rickhc5a/tesis-3dcp-kuka/05_latex/fig/second0.png

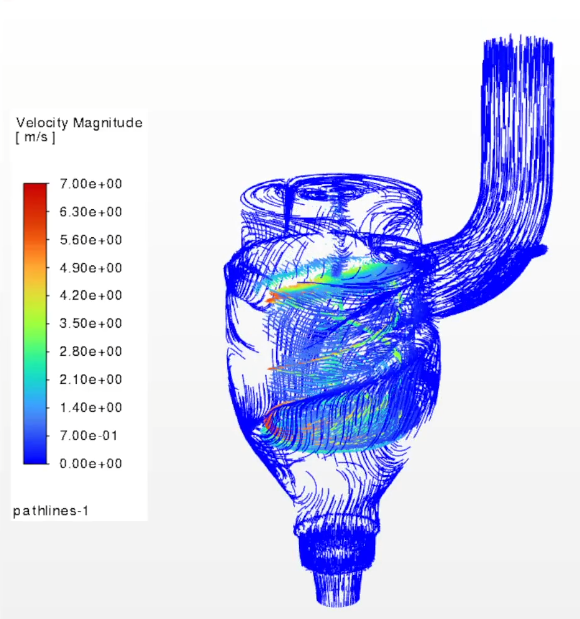
05_latex/fig/second0.png
