rickhc5a/tesis-3dcp-kuka/01_grasshopper/README.md

# 01_grasshopper

Descripción de la carpeta.
