rickhc5a/tesis-3dcp-kuka/05_latex/fig/nozzle_concept.png

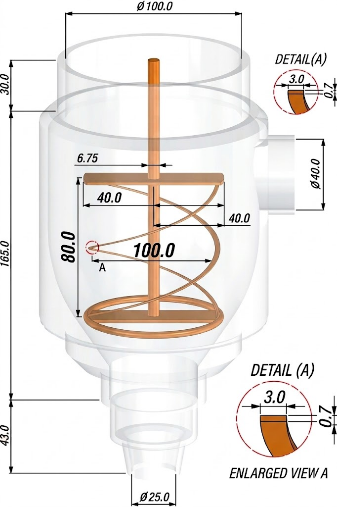
05_latex/fig/nozzle_concept.png
