rickhc5a/tesis-3dcp-kuka/05_latex/fig/pipe_concept.png.png

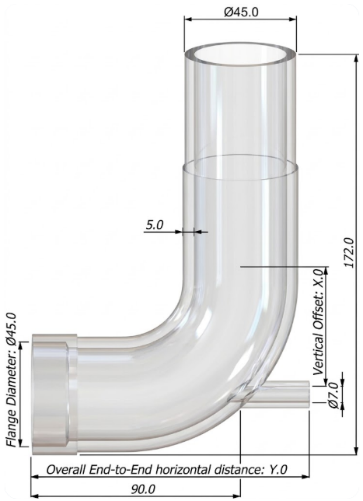
05_latex/fig/pipe_concept.png.png
