rickhc5a/tesis-3dcp-kuka/05_latex/fig/TORQUE.png

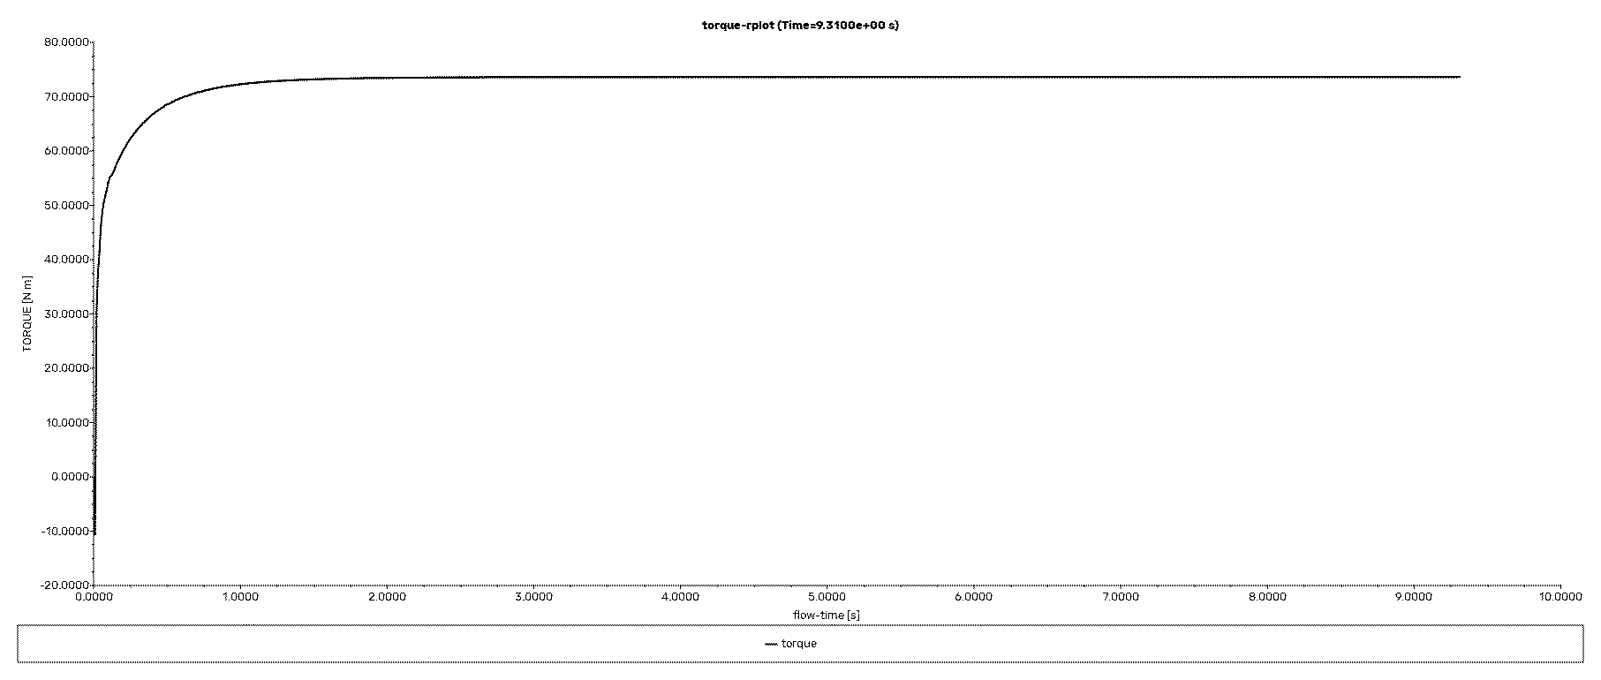
05_latex/fig/TORQUE.png
