rickhc5a/tesis-3dcp-kuka/05_latex/fig/velocity_map.png

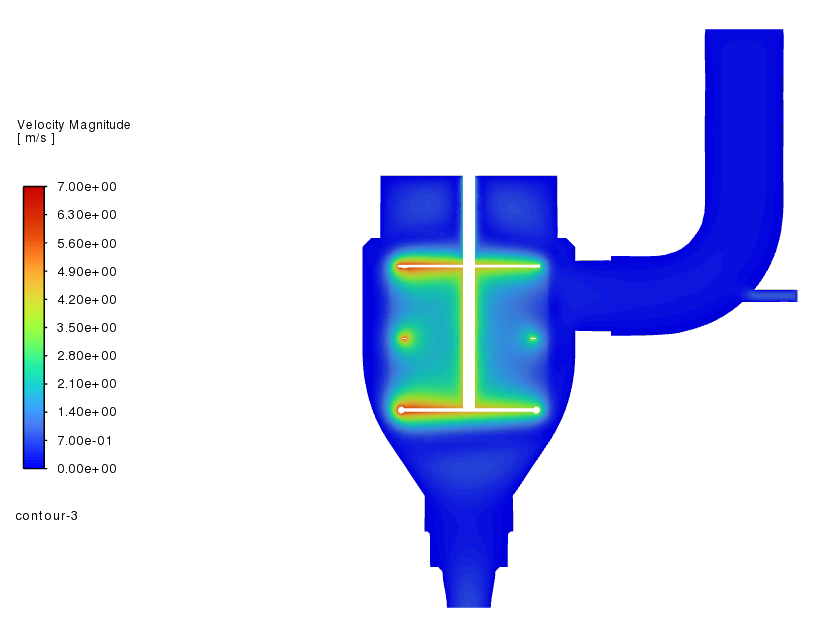
05_latex/fig/velocity_map.png
