rickhc5a/tesis-3dcp-kuka/04_cad/3DCP-NOZZLEv2-abril.stp

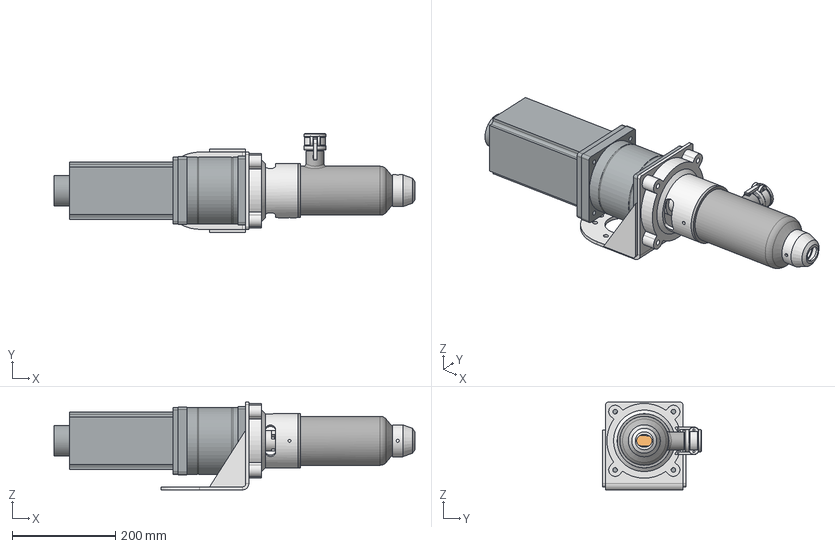
[picture p7: CAD file, 2026-05-12]
04_cad/3DCP-NOZZLEv2-abril.stp
700.5 x 191.9 x 170.2 mm
MEZCLADOR-TRUPPER-80MM
PX130-GEARBOX
SERVOMOTOR-2.3KWv1
AS 1110 - M20 x 80
NYLON-JAW
22MM JAW
22MM JAW_1
NOZZLE-FLANGE
NOZZLE-ELIPTICO
LOWER-NOZZLEv2
UPPER-NOZZLEvF2.0
