rickhc5a/tesis-3dcp-kuka/04_cad/KUKA KR 60-3/KR60-3.stl

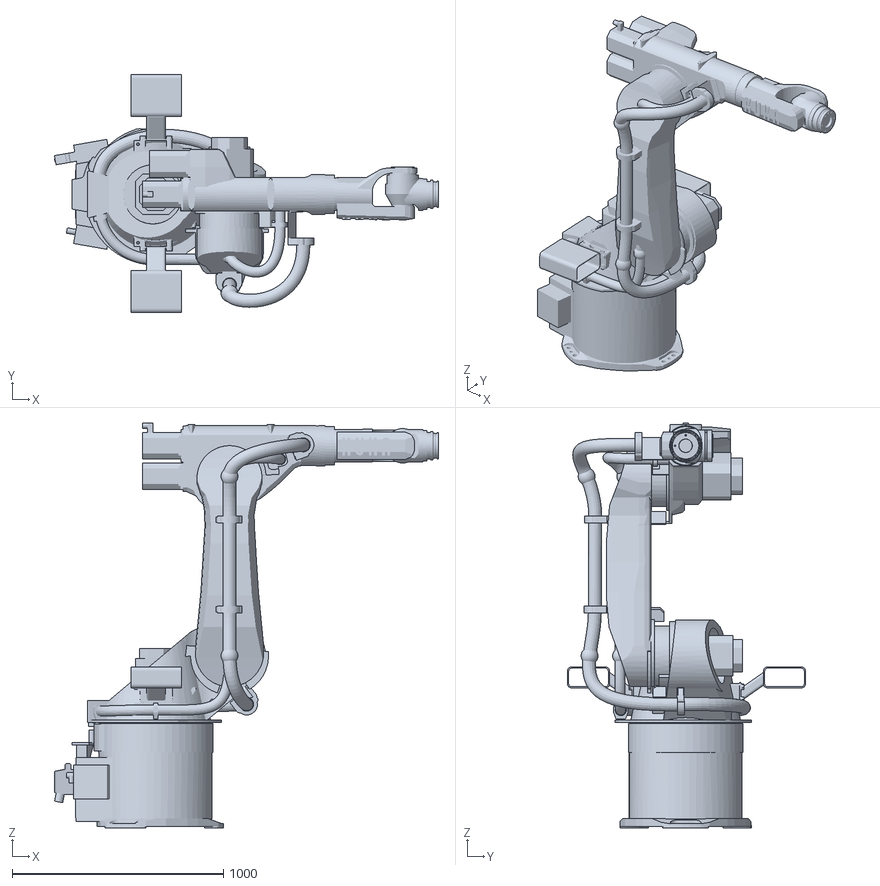
[picture p8: CAD file, 2026-05-12]
04_cad/KUKA KR 60-3/KR60-3.stl
1819.2 x 1128.0 x 1917.8
