rickhc5a/tesis-3dcp-kuka/04_cad/3DCP-NOZZLEv2.stp

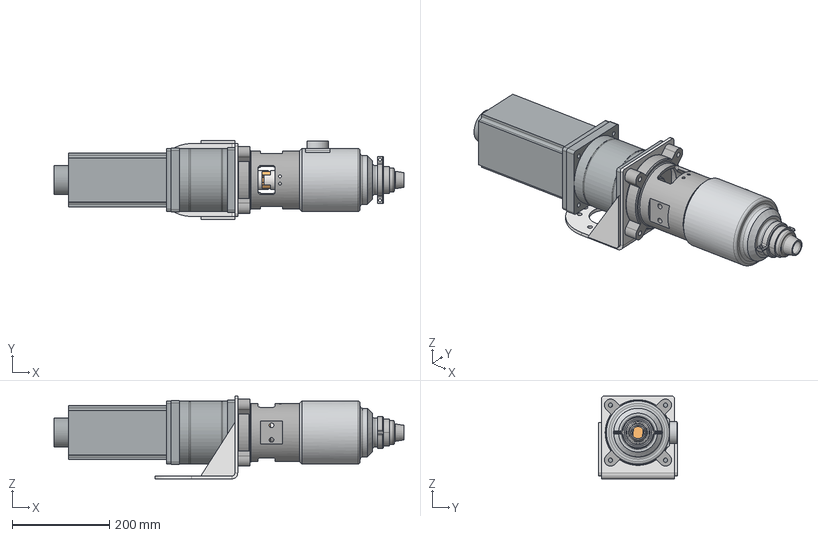
[picture p9: CAD file, 2026-05-12]
04_cad/3DCP-NOZZLEv2.stp
720.0 x 162.0 x 170.2 mm
LOWER-NOZZLEv2
UPPER-NOZZLEv2
EXTRUSSOR-COUPLINGv2 x 2
NOZZLE-EXTRUSOR
MEZCLADOR-TRUPPER-80MM
PX130-GEARBOX
SERVOMOTOR-2.3KWv1
AS 1110 - M20 x 80
NYLON-JAW
22MM JAW
22MM JAW_1
NOZZLE-FLANGE
