rickhc5a/tesis-3dcp-kuka/(list of files, cad)

Other CAD files:
04_cad/220LB LOCK/220LB-ASSY.iam
04_cad/220LB LOCK/220LB-ASSY_MIR.iam
04_cad/220LB LOCK/BODY-220LB.ipt
04_cad/220LB LOCK/BODY-220LB_MIR.ipt
04_cad/220LB LOCK/GRIPPER-220LB.ipt
04_cad/220LB LOCK/GRIPPER-220LB_MIR.ipt
04_cad/220LB LOCK/HEAD-220LB.ipt
04_cad/220LB LOCK/OldVersions/220LB-ASSY.0009.iam
04_cad/220LB LOCK/OldVersions/220LB-ASSY_MIR.0001.iam
04_cad/220LB LOCK/OldVersions/BODY-220LB.0005.ipt
04_cad/220LB LOCK/OldVersions/GRIPPER-220LB.0005.ipt
04_cad/220LB LOCK/OldVersions/PLATE-220.0003.ipt
04_cad/220LB LOCK/PLATE-220.ipt
04_cad/220LB LOCK/PLATE-220_MIR.ipt
04_cad/3DCP-NOZZLE.iam
04_cad/3DCP-NOZZLEv2.iam
04_cad/3DCP-NOZZLEv2.ipn
04_cad/3DCP-SYSTEM.iam
04_cad/ACOPLE CAMLOCK B 3-4in.ipt
04_cad/AUGER-SCREW.ipt
04_cad/COMPONENTS/1-1&2 FEMALE ADAPTER.ipt
04_cad/COMPONENTS/20MM JAW.ipt
04_cad/COMPONENTS/22MM JAW.ipt
04_cad/COMPONENTS/22mm-BEARING.iam
04_cad/COMPONENTS/62_22_01.ipt
04_cad/COMPONENTS/62_22_02.ipt
04_cad/COMPONENTS/62_22_03.ipt
04_cad/COMPONENTS/CAMLOCK TIPO B 3'4IN.ipt
04_cad/COMPONENTS/JAW-COUPLING-ID22MM.iam
04_cad/COMPONENTS/LOWER-JAW.ipt
04_cad/COMPONENTS/M4-HEATINSERT.ipt
04_cad/COMPONENTS/M8-HEATINSERT.ipt
04_cad/COMPONENTS/MEZCLADOR-TRUPPER-80MM.ipt
04_cad/COMPONENTS/MOTOR5HP.ipt
04_cad/COMPONENTS/NYLON-JAW.ipt
04_cad/COMPONENTS/OldVersions/20MM JAW.0001.ipt
04_cad/COMPONENTS/OldVersions/22MM JAW.0002.ipt
04_cad/COMPONENTS/OldVersions/22mm-BEARING.0001.iam
04_cad/COMPONENTS/OldVersions/CAMLOCK TIPO B 3'4IN.0001.ipt
04_cad/COMPONENTS/OldVersions/JAW-COUPLING-ID22MM.0003.iam
04_cad/COMPONENTS/OldVersions/JAW-COUPLING.0001.ipt
04_cad/COMPONENTS/OldVersions/LOWER-JAW.0003.ipt
04_cad/COMPONENTS/OldVersions/M4-HEATINSERT.0002.ipt
04_cad/COMPONENTS/OldVersions/MEZCLADOR-TRUPPER-80MM.0002.ipt
04_cad/COMPONENTS/OldVersions/NYLON-JAW.0002.ipt
04_cad/COMPONENTS/OldVersions/PX130-GEARBOX.0005.ipt
04_cad/COMPONENTS/OldVersions/SERVOMOTOR-1KW.0005.ipt
04_cad/COMPONENTS/OldVersions/SERVOMOTOR-2.3KWv1.0001.ipt
04_cad/COMPONENTS/PX130-GEARBOX.ipt
04_cad/COMPONENTS/SCREW-ROTOR.ipt
04_cad/COMPONENTS/SERVOMOTOR-1KWv1.ipt
04_cad/COMPONENTS/SERVOMOTOR-2.3KWv1.ipt
04_cad/EXTRUSSOR-COUPLING.ipt
04_cad/EXTRUSSOR-COUPLINGv2.ipt
04_cad/FEE-PIPE.ipt
04_cad/GEARBOX-SUPPORT.ipt
04_cad/HOSE-NOZZLE-MOUNTING.ipt
04_cad/KUKA KR 60-3/KR60-3.ipt
04_cad/LOWER-NOZZLE.ipt
04_cad/LOWER-NOZZLEv2.ipt
04_cad/LOWER-NOZZLEv3.ipt
04_cad/M20 x 80.ipt
04_cad/MOTOR-BRACKET.ipt
04_cad/MOUNTING-COUPLE.ipt
04_cad/NOZZLE-EXTRUSOR.ipt
04_cad/NOZZLE-FLANGE.ipt
04_cad/NOZZLES/NOZZLE-ELIPTICO.ipt
04_cad/NOZZLES/OldVersions/NOZZLE-ELIPTICO.0006.ipt
04_cad/OldVersions/3DCP-NOZZLE.0017.iam
04_cad/OldVersions/3DCP-NOZZLEv2.0030.iam
04_cad/OldVersions/ACOPLE CAMLOCK B 3-4in.0003.ipt
04_cad/OldVersions/AUGER-SCREW.0025.ipt
04_cad/OldVersions/EXTRUSSOR-COUPLING.0001.ipt
04_cad/OldVersions/EXTRUSSOR-COUPLINGv2.0001.ipt
04_cad/OldVersions/FEE-PIPE.0011.ipt
04_cad/OldVersions/GEARBOX-SUPPORT.0009.ipt
04_cad/OldVersions/HOSE-NOZZLE-MOUNTING.0009.ipt
04_cad/OldVersions/LOWER-NOZZLE.0002.ipt
04_cad/OldVersions/LOWER-NOZZLEv2 - copia.0017.ipt
04_cad/OldVersions/LOWER-NOZZLEv2.0016.ipt
04_cad/OldVersions/LOWER-NOZZLEv2.0017.ipt
04_cad/OldVersions/LOWER-NOZZLEv3.0017.ipt
04_cad/OldVersions/M20 x 80.0004.ipt
04_cad/OldVersions/MOTOR-BRACKET.0007.ipt
04_cad/OldVersions/MOUNTING-COUPLE.0006.ipt
04_cad/OldVersions/NOZZLE-EXTRUSOR.0003.ipt
04_cad/OldVersions/NOZZLE-FLANGE.0001.ipt
04_cad/OldVersions/PAPER-VIEW.0003.iam
04_cad/OldVersions/SYSTEM-FLANGE-K60.0001.ipt
04_cad/OldVersions/SYSTEM-FLANGE-LOWER.0004.ipt
04_cad/OldVersions/SYSTEM-FLANGE.0006.iam
04_cad/OldVersions/UPPER-NOZZLE.0022.ipt
04_cad/OldVersions/UPPER-NOZZLEv2.0016.ipt
04_cad/OldVersions/UPPER-NOZZLEv3.0014.ipt
04_cad/OldVersions/UPPER-NOZZLEv3.1.0005.ipt
04_cad/OldVersions/UPPER-NOZZLEvF2.0.0005.ipt
04_cad/PAPER-VIEW.iam
04_cad/PLANOS/3DCP-NOZZLE.idw
04_cad/PLANOS/3DCP-NOZZLEv2-ASSY.idw
04_cad/PLANOS/3DCP-NOZZLEv2.idw
04_cad/PLANOS/FLANGE-INFERIOR.idw
04_cad/PLANOS/FLANGE-SUPERIOR.idw
04_cad/PLANOS/LOWER-NOZZLE.idw
04_cad/PLANOS/OldVersions/3DCP-NOZZLE.0002.idw
04_cad/PLANOS/OldVersions/3DCP-NOZZLEv2.0001.idw
04_cad/PLANOS/OldVersions/FLANGE-SUPERIOR.0002.idw
04_cad/PLANOS/PAPER-VIEWS.idw
04_cad/PLANOS/UPPER-NOZZLE.idw
04_cad/SYSTEM-FLANGE-K60.ipt
04_cad/SYSTEM-FLANGE-LOWER.ipt
04_cad/SYSTEM-FLANGE.iam
04_cad/UPPER-NOZZLE.ipt
04_cad/UPPER-NOZZLEv2.ipt
04_cad/UPPER-NOZZLEv3.1.ipt
04_cad/UPPER-NOZZLEv3.ipt
04_cad/UPPER-NOZZLEvF1.0.ipt
04_cad/UPPER-NOZZLEvF2.0.ipt
