rickhc5a/tesis-3dcp-kuka/04_cad/PLANOS/PAPER-VIEW.pdf

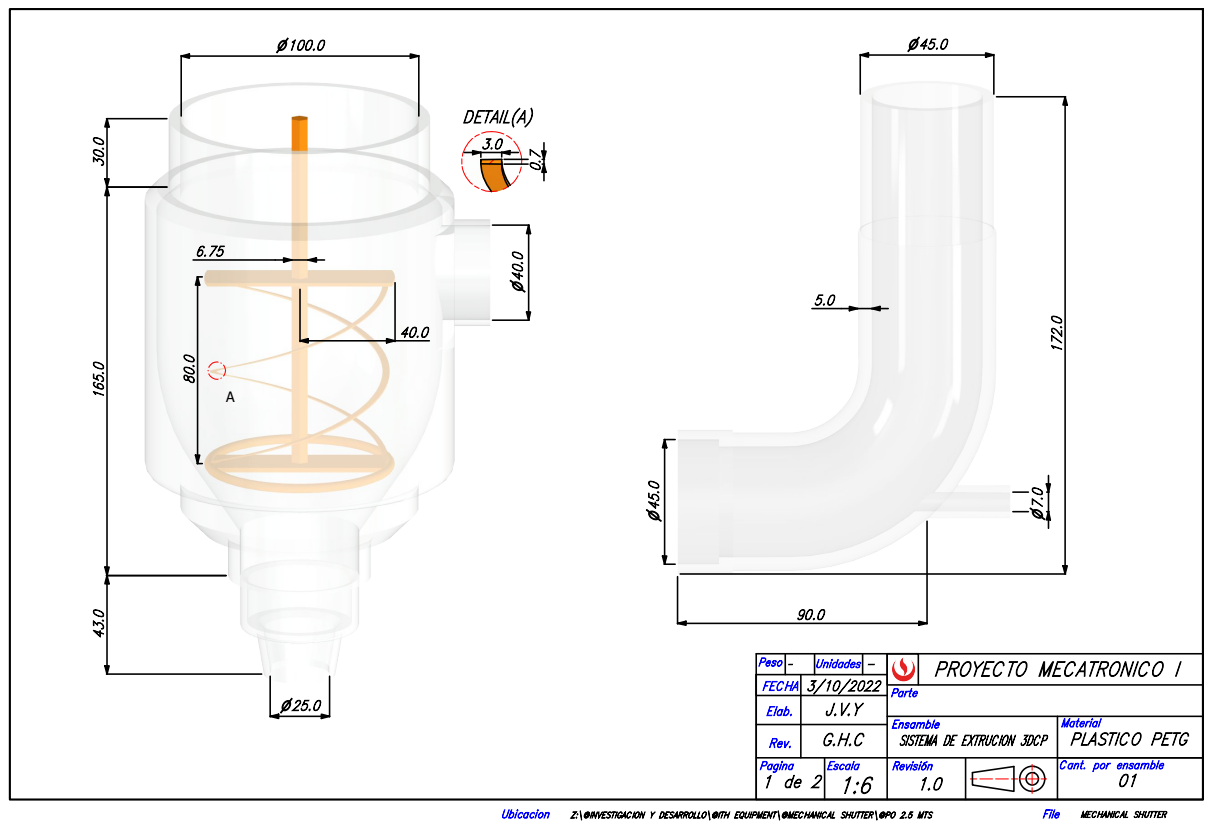
[picture p10: page 1]
Ubicacion; Z:\@INVESTIGACION Y DESARROLLO\@ITH EQUIPMENT\@MECHANICAL SHUTTER\@PO 2.5 MTS; File; MECHANICAL SHUTTER

Peso - | | Unidades - | PROYECTO MECATRONICO I
FECHA | 3/10/2022

Elab. | J.V.Y

Ensamble SISTEMA DE EXTRUCION 3DCP | Material PLASTICO PETG

Rev. | G.H.C
Pagina 1 de 2 | Escala 1:6 | Revisión 1.0 | Cant. por ensamble 01
