rickhc5a/tesis-3dcp-kuka/04_cad/PLANOS/3DCP-NOZZLE.pdf

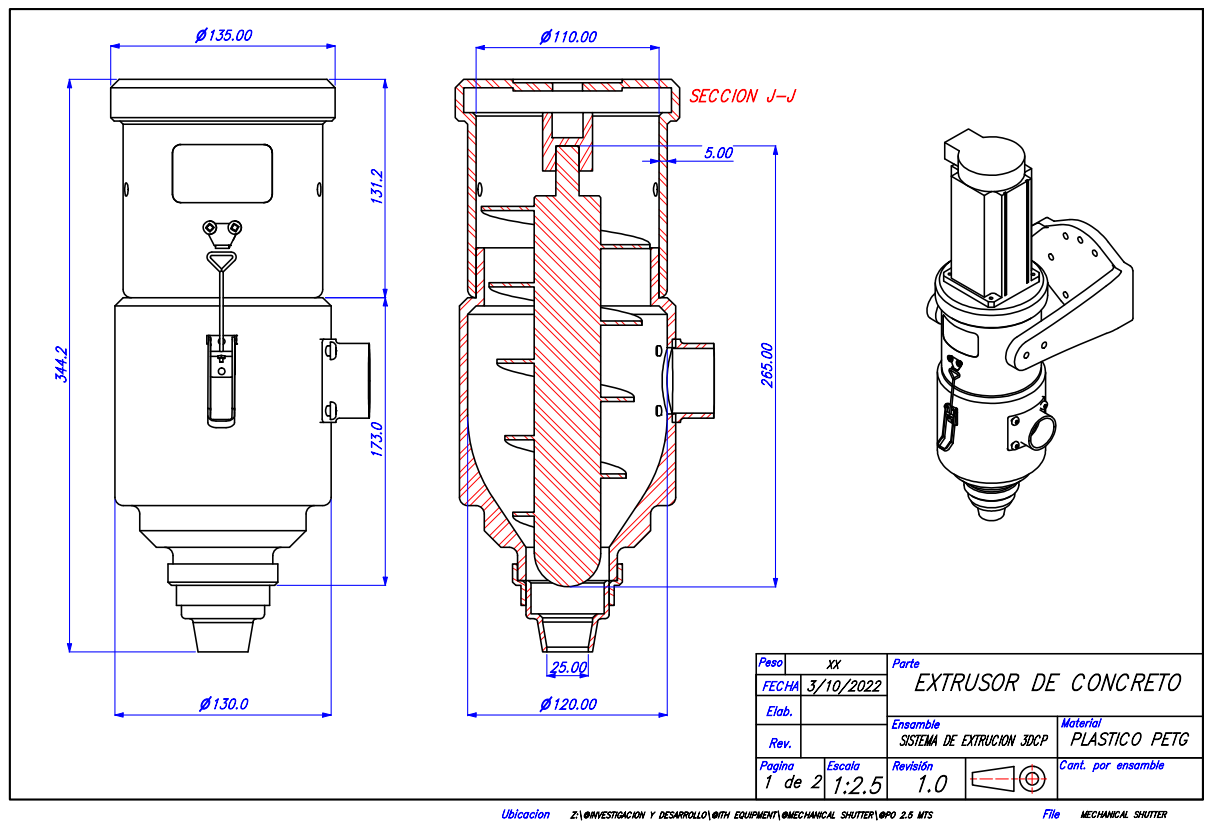
[picture p11: page 1]
SECCION J-J; Ubicacion; Z:\@INVESTIGACION Y DESARROLLO\@ITH EQUIPMENT\@MECHANICAL SHUTTER\@PO 2.5 MTS; File; MECHANICAL SHUTTER

Parte
EXTRUSOR DE CONCRETO

Elab.

Ensamble SISTEMA DE EXTRUCION 3DCP | Material PLASTICO PETG

Rev.
Pagina 1 de 2 | Escala 1:2.5 | Revisión 1.0 | Cant. por ensamble
