rickhc5a/tesis-3dcp-kuka/04_cad/PLANOS/3DCP-NOZZLEv2-ASSY.pdf

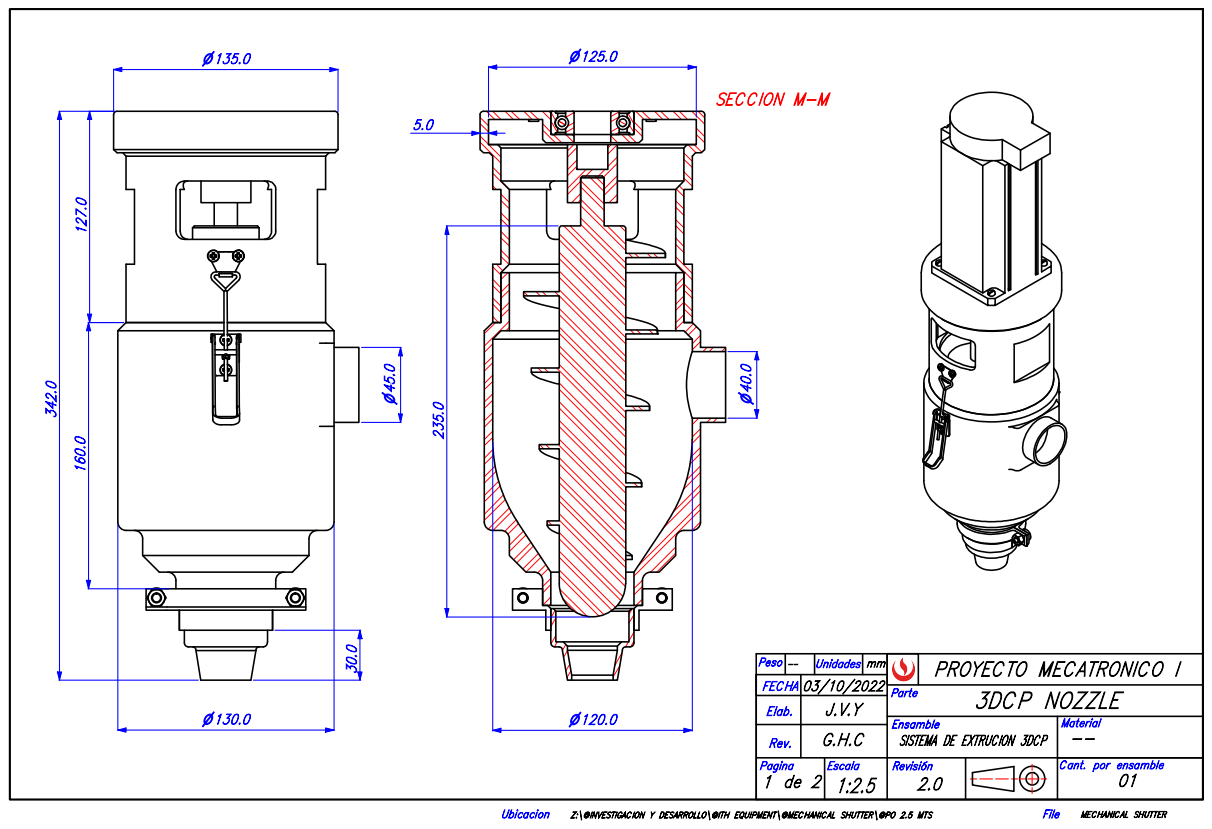
[picture p12: page 1]
SECCION M-M; Ubicacion; Z:\@INVESTIGACION Y DESARROLLO\@ITH EQUIPMENT\@MECHANICAL SHUTTER\@PO 2.5 MTS; File; MECHANICAL SHUTTER; 3DCP NOZZLE

Peso -- | | Unidades mm | PROYECTO MECATRONICO I
FECHA 03/10/2022

Elab. | J.V.Y

Ensamble SISTEMA DE EXTRUCION 3DCP | Material --

Rev. | G.H.C
Pagina 1 de 2 | Escala 1:2.5 | Revisión 2.0 | Cant. por ensamble 01
