rickhc5a/tesis-3dcp-kuka/04_cad/PLANOS/3DCP-NOZZLEv2-DESPIECE.pdf

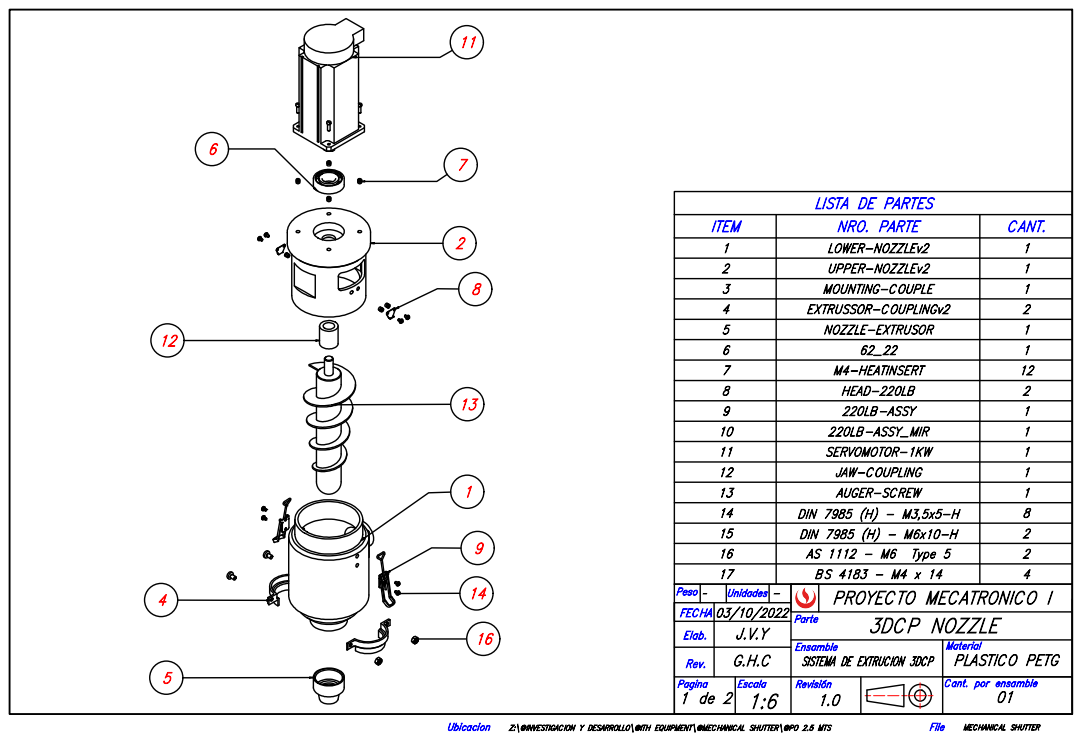
[picture p13: page 1]
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

LISTA DE PARTES

ITEM | NRO. PARTE | CANT.
1 | LOWER-NOZZLEv2 | 1
2 | UPPER-NOZZLEv2 | 1
3 | MOUNTING-COUPLE | 1
4 | EXTRUSSOR-COUPLINGv2 | 2
5 | NOZZLE-EXTRUSOR | 1
6 | 62_22 | 1
7 | M4-HEATINSERT | 12
8 | HEAD-220LB | 2
9 | 220LB-ASSY | 1
10 | 220LB-ASSY_MIR | 1
11 | SERVOMOTOR-1KW | 1
12 | JAW-COUPLING | 1
13 | AUGER-SCREW | 1
14 | DIN 7985 (H) - M3,5x5-H | 8
15 | DIN 7985 (H) - M6x10-H | 2
16 | AS 1112 - M6 Type 5 | 2
17 | BS 4183 - M4 x 14 | 4
Peso - | | Unidades - | PROYECTO MECATRONICO I
FECHA 03/10/2022

Elab. | J.V.Y

Ensamble SISTEMA DE EXTRUCION 3DCP | Material PLASTICO PETG

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
