rickhc5a/tesis-3dcp-kuka/04_cad/PLANOS/LOWER-NOZZLE.pdf

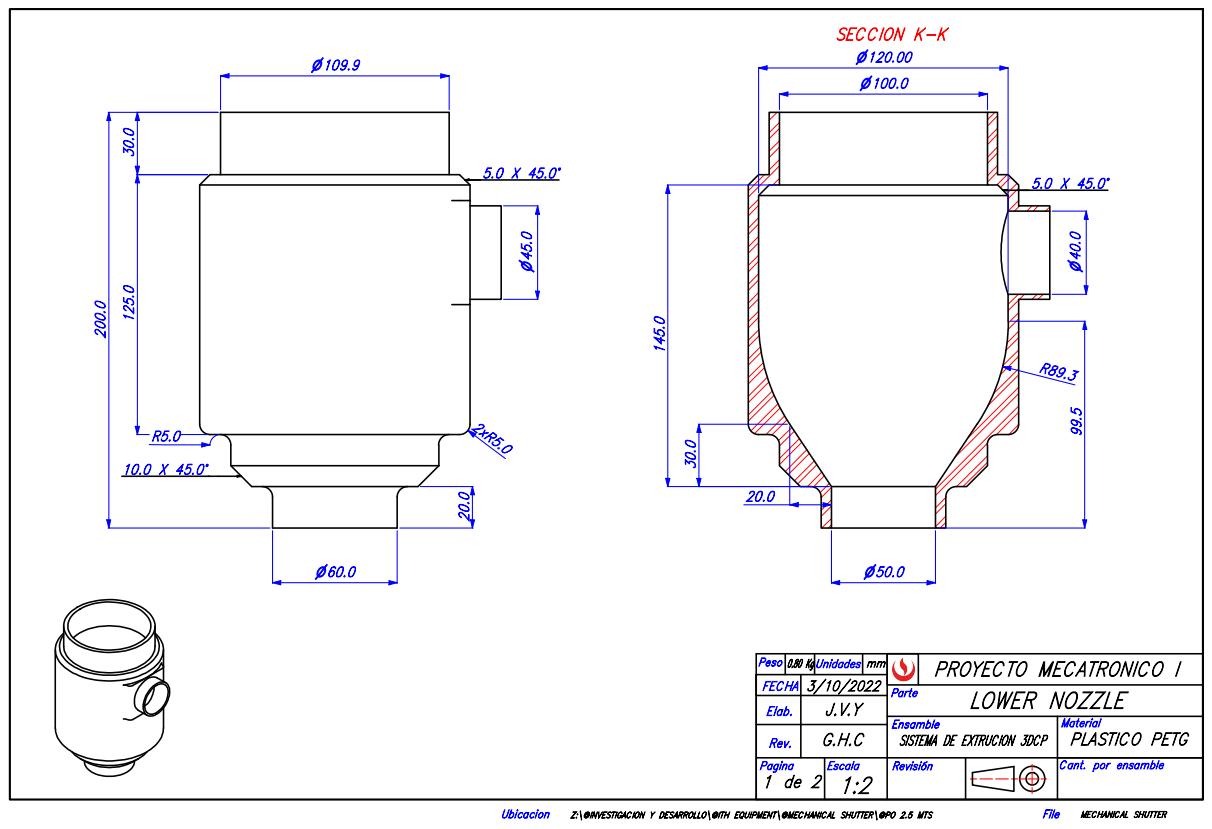
[picture p14: page 1]
SECCION K-K; Ubicacion; Z:\@INVESTIGACION Y DESARROLLO\@ITH EQUIPMENT\@MECHANICAL SHUTTER\@PO 2.5 MTS; File; MECHANICAL SHUTTER; LOWER NOZZLE

Peso 0.80 Kg | | Unidades mm | PROYECTO MECATRONICO I
FECHA | 3/10/2022

Elab. | J.V.Y

Ensamble SISTEMA DE EXTRUCION 3DCP | Material PLASTICO PETG

Rev. | G.H.C
Pagina 1 de 2 | Escala 1:2 | Revisión | Cant. por ensamble
