rickhc5a/tesis-3dcp-kuka/04_cad/PLANOS/UPPER-NOZZLE.pdf

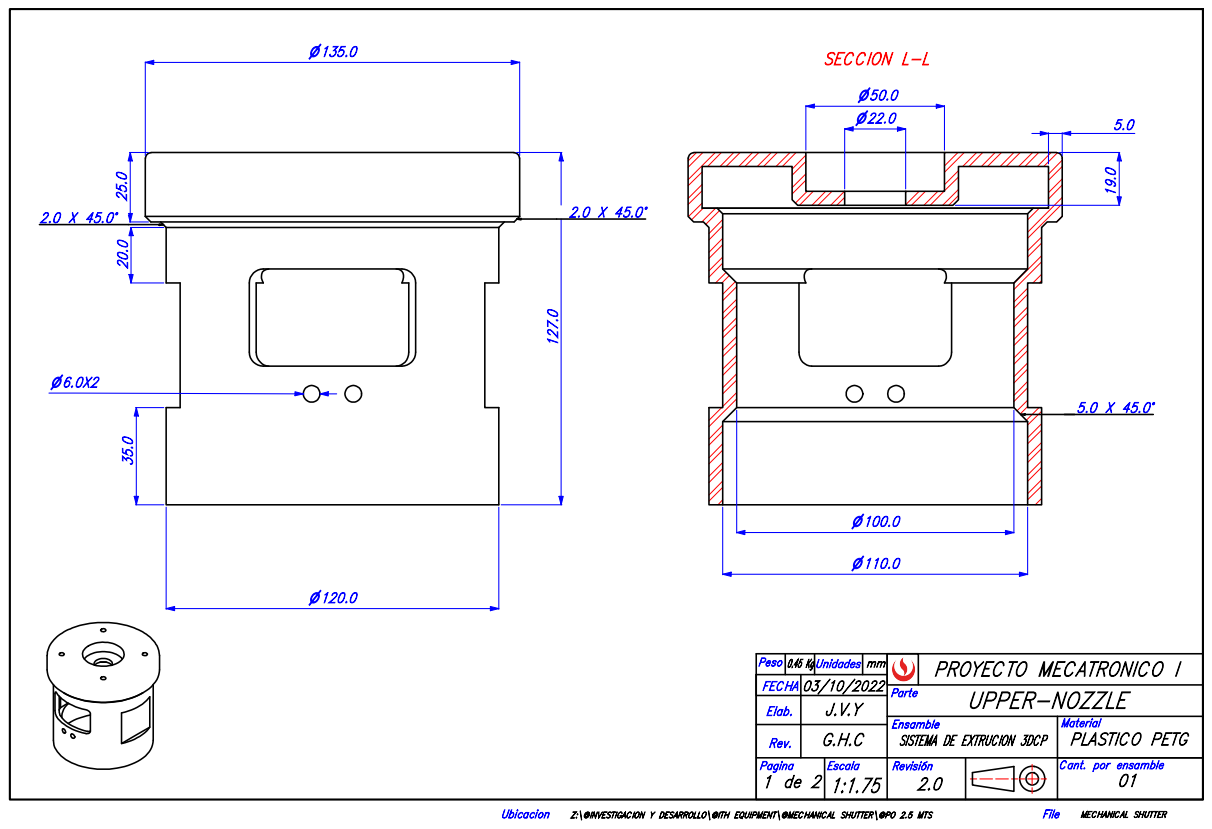
[picture p15: page 1]
SECCION L-L; Ubicacion; Z:\@INVESTIGACION Y DESARROLLO\@ITH EQUIPMENT\@MECHANICAL SHUTTER\@PO 2.5 MTS; File; MECHANICAL SHUTTER

Peso 0.45 Kg | | Unidades mm | PROYECTO MECATRONICO I
FECHA 03/10/2022

Elab. | J.V.Y

Ensamble SISTEMA DE EXTRUCION 3DCP | Material PLASTICO PETG

Rev. | G.H.C
Pagina 1 de 2 | Escala 1:1.75 | Revisión 2.0 | Cant. por ensamble 01
